folknology/IceCore/README.md

# IceCore
IceCore Ice40 HX based modular developement core 

**Top View**
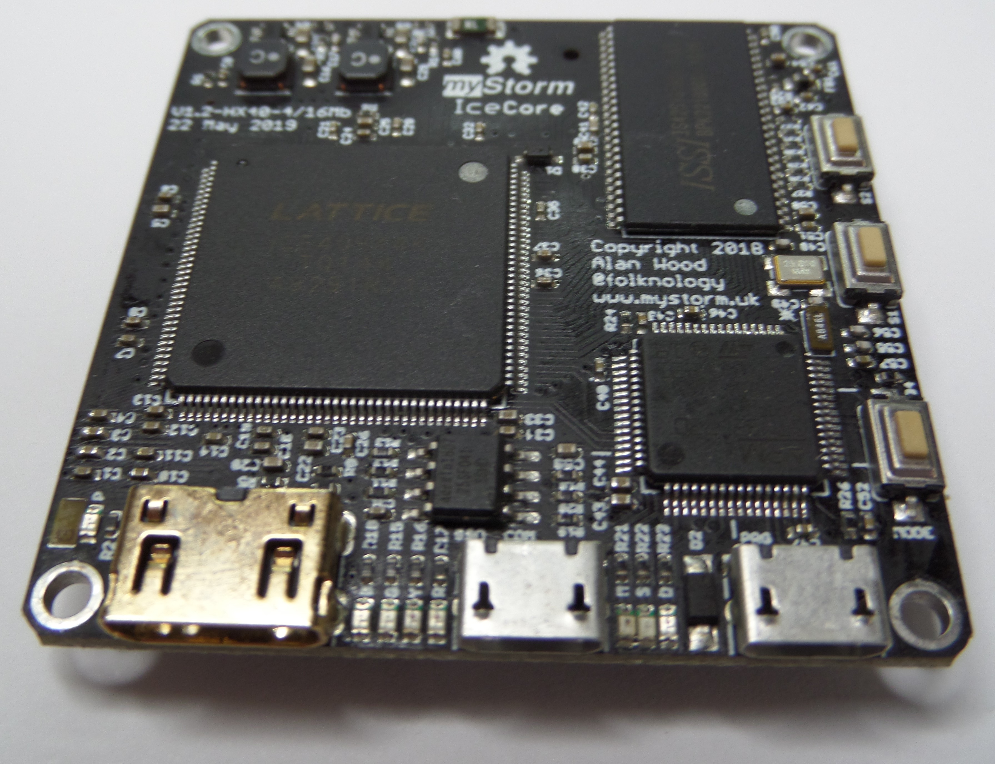
[picture p1: cad/IceCore.jpg]
IceCore Module

**Bottom View**
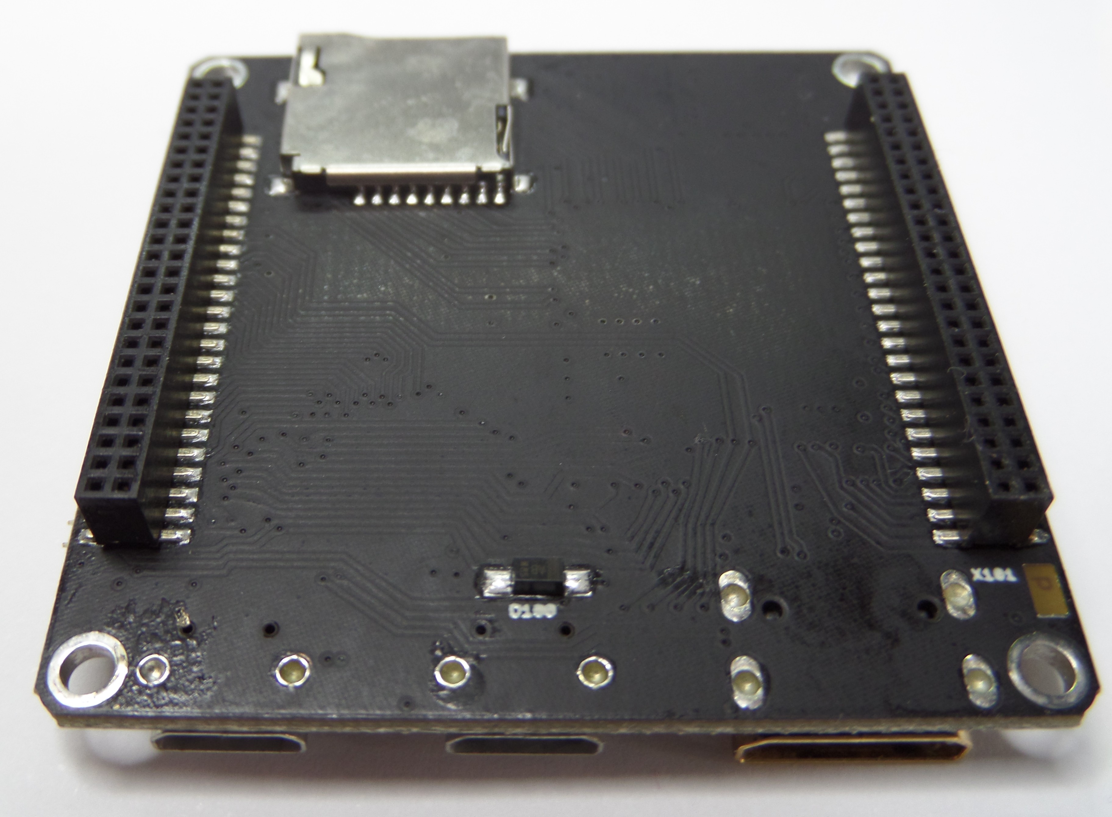
[picture p2: cad/IceCore-Bottom.jpg]
IceCore Module


**Features**
* Ice40 HX4K - 4K Luts (8K for Yosys), 80/(128)Kbits BRAM, 2 PLLs, NVCM
* 16Mbit SDRAM 16 bits wide (143Mhz)
* 16Mbit Flash QSPI/SPI (100Mhz)
* 56 General purpose IOs, SPI, Uart, I2C/Can
* Stm32F730 200Mhz, 256KB Ram, 64KB Flash
* Triple 2.5MSPS ADCs (interleaved to 7.2MSPS)
* Dedicated Programming and debug USB 2.0FS
* Uart/Application specific USB2.0FS
* Digital video connector
* SDCard connector
* 4 Coloured Status LEDs
* 4 Coloured User LEDs
* 2 User buttons, 1 Mode/Boot buttoni

[Get it from Tindie as part of BlackIce Mx](https://www.tindie.com/products/Folknology/blackice-mx/)

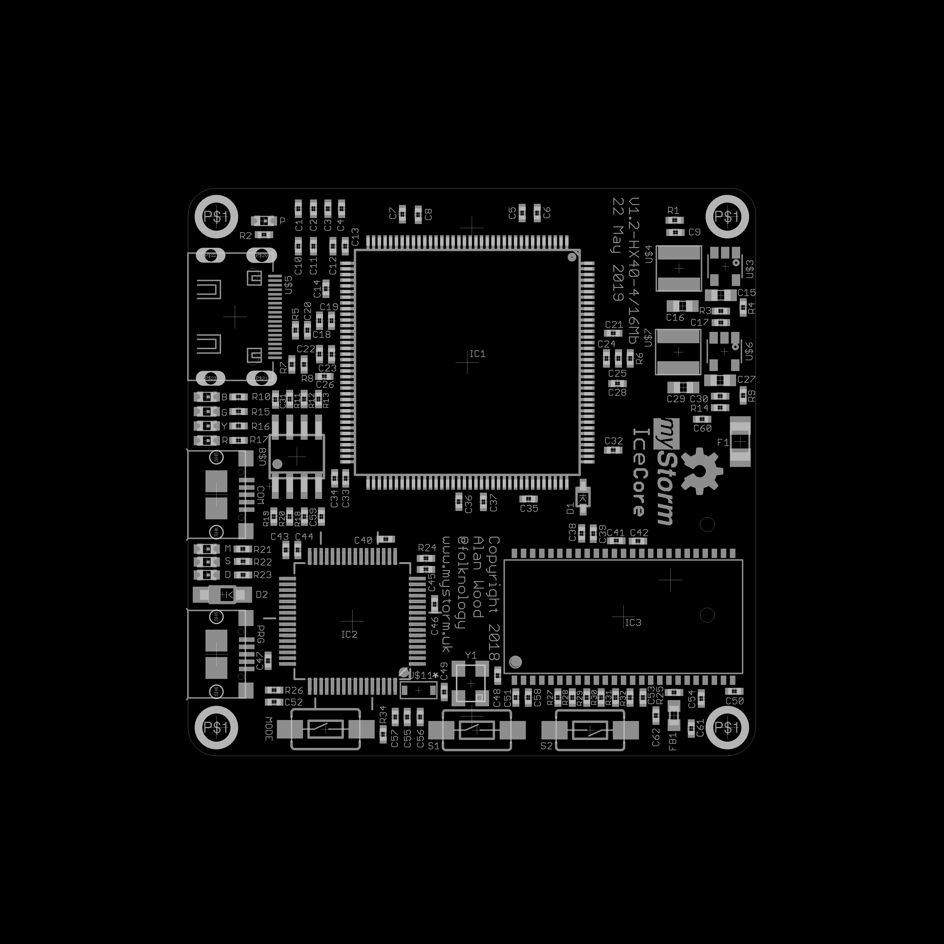
[picture p3: cad/IceCore.png]
IceCore Module


Schematic

Core modules can be combined with different carrier boards for example [BlackIce Mx](https://github.com/folknology/BlackIceMx)

Supports the [BlackEdge connectivity](https://github.com/folknology/BlackEdge) carriers

Some further [background information](https://forum.mystorm.uk/t/new-product-blackice-mx/551/10) can be found on the [myStorm forum](https://forum.mystorm.uk)
