folknology/IceCore/(threads)

Thread 4 (2019-07-11):

Add 2nd USB support

folknology, 2019-07-11:
Add support for 2nd USB CDC class in firmware based around USB HS and Uart1

folknology, 2019-07-29:
A preview of the new firmware including this functionality along with refactored Ice40 programming code in C++ https://github.com/folknology/IceCore/tree/USB-CDC-issue-3

rvalles, 2020-11-03:
@folknology
I'm trying to support blackice mx on [some project](https://github.com/rvalles/dbus_ti_link_uart_verilog/).
stm32 uart baud rate facing the FPGA is hardcoded to 115200. Combined with the lack of hardware flow control, my design's FIFO does overrun, thus I have to depend on an external usb-serial converter, as the alternative would be too much work for one board's special case.
It would be best if uart speed was set to computer's requested speed.
