folknology/IceCore/cad/IceCore-Schematic.pdf

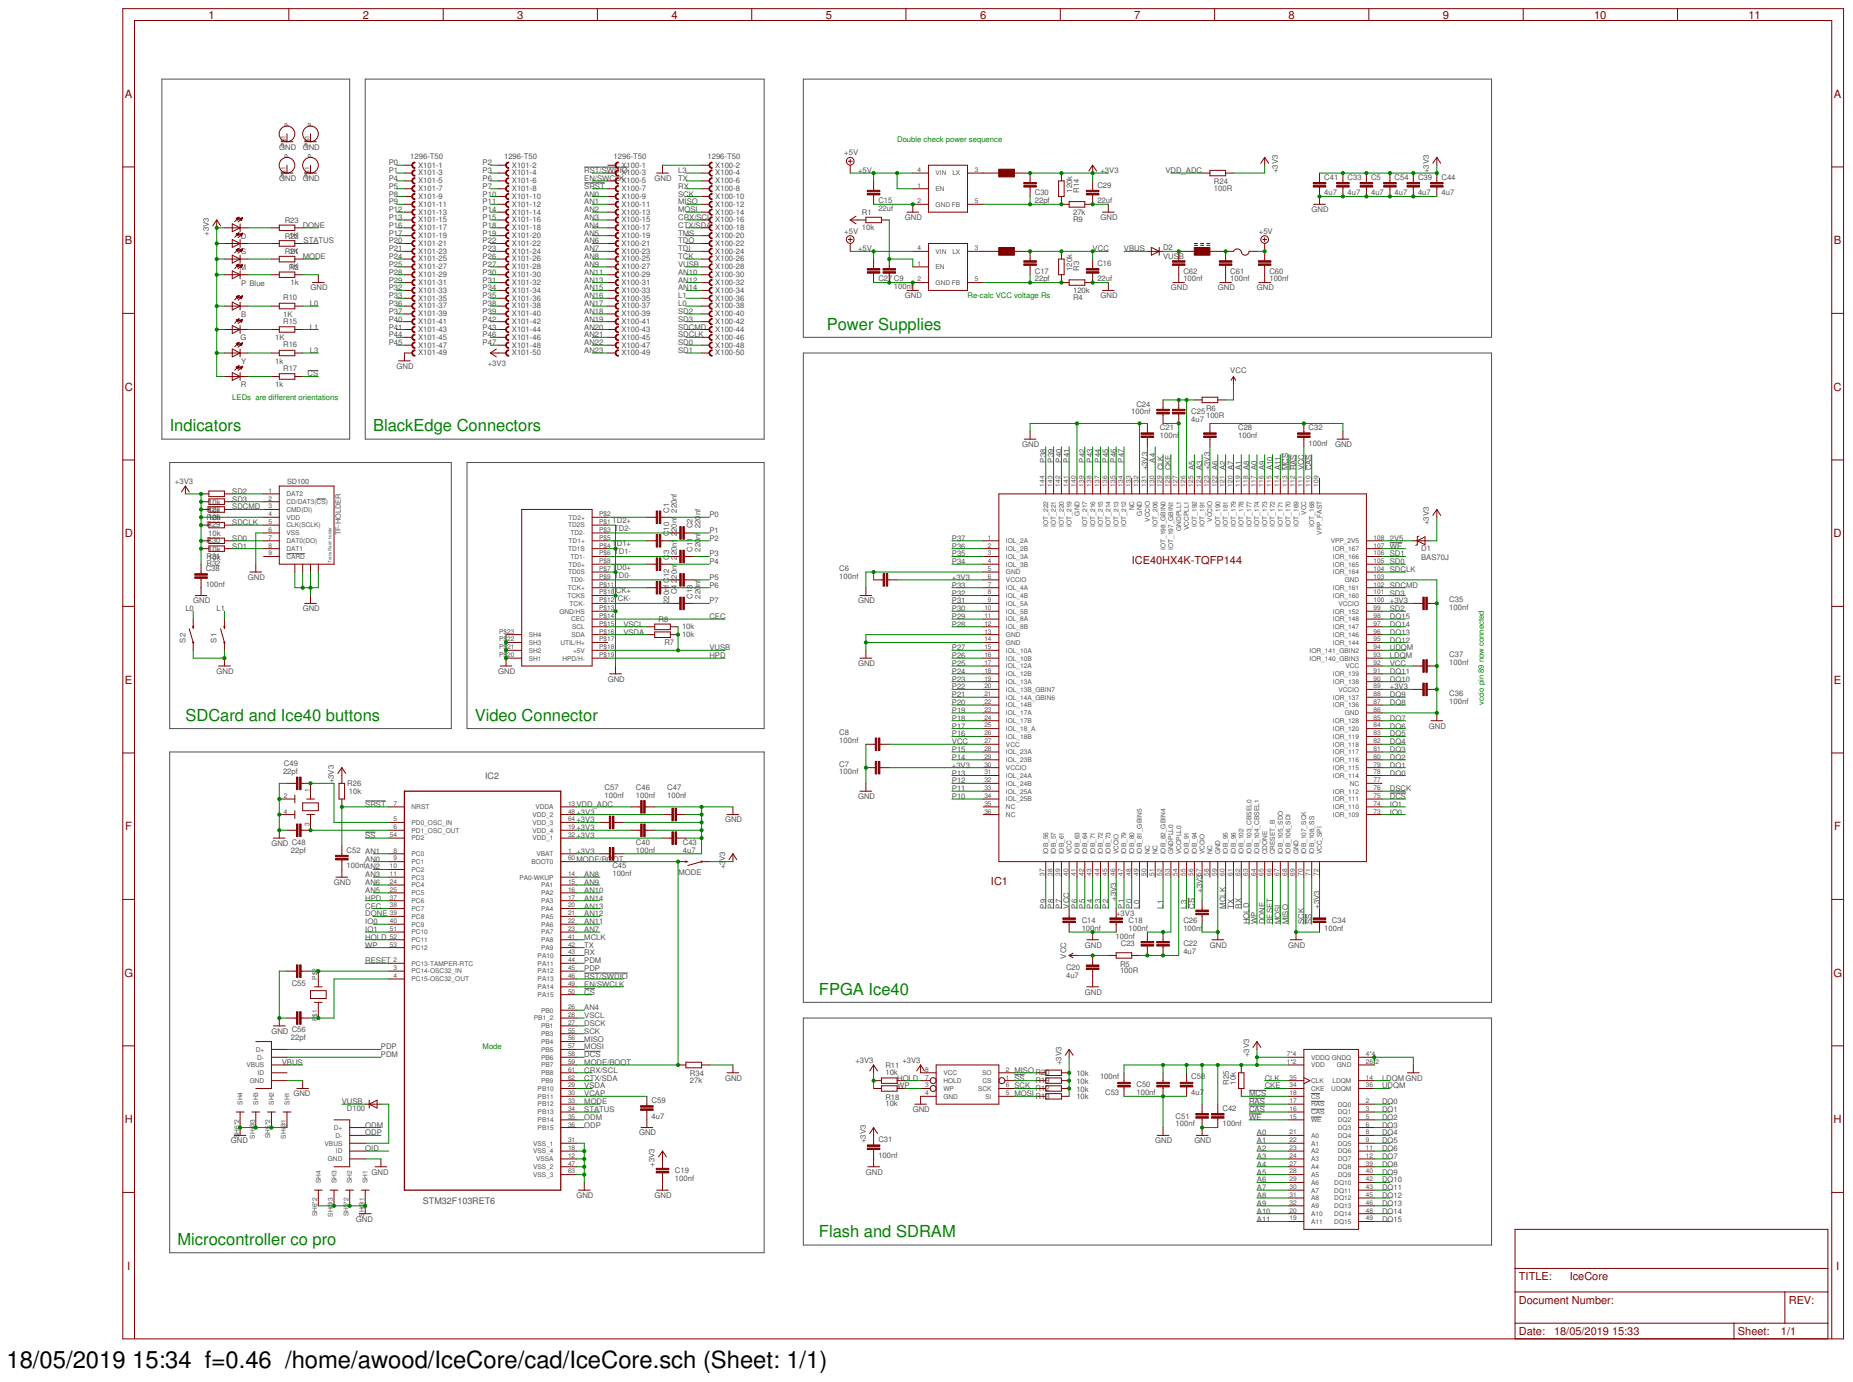
[picture p4: page 1]

GND GND

Double check power sequence

Re-calc VCC voltage Rs

LEDs are different orientations

vccio pin 89 now connected

Flash and SDRAM Microcontroller co pro

18/05/2019 15:34 f=0.46 /home/awood/IceCore/cad/IceCore.sch (Sheet: 1/1)
