folknology/IceCore/firmware/IceCore.ioc

Mcu.UserName=STM32F730R8Tx
PA0-WKUP.Signal=ADCx_IN0
PA1.Signal=ADCx_IN1
PA10.Signal=USART1_RX
PA11.Signal=USB_OTG_FS_DM
PA12.Signal=USB_OTG_FS_DP
PA13.Signal=SYS_JTMS-SWDIO
PA14.Signal=SYS_JTCK-SWCLK
PA15.Signal=SPI3_NSS
PA2.Signal=ADCx_IN2
PA3.Signal=ADCx_IN3
PA4.Signal=ADCx_IN4
PA5.Signal=ADCx_IN5
PA6.Signal=ADCx_IN6
PA7.Signal=ADCx_IN7
PA8.Signal=RCC_MCO_1
PA9.Signal=USART1_TX
PB0.Signal=ADCx_IN8
PB1.Signal=ADCx_IN9
PB10.Signal=I2C2_SCL
PB11.Signal=I2C2_SDA
PB12.GPIO_Label=MODE_LED
PB12.Signal=GPIO_Output
PB13.GPIO_Label=STATUS_LED
PB13.Signal=GPIO_Output
PB14.Signal=USB_OTG_HS_DM
PB15.Signal=USB_OTG_HS_DP
PB2.Signal=QUADSPI_CLK
PB3.Signal=SPI3_SCK
PB4.Signal=SPI3_MISO
PB5.Signal=SPI3_MOSI
PB6.Signal=QUADSPI_BK1_NCS
PB7.GPIO_Label=MODE_BOOT
PB7.Signal=GPIO_Input
PB8.Signal=I2C1_SCL
PB9.Signal=I2C1_SDA
PC0.Signal=ADCx_IN10
PC1.Signal=ADCx_IN11
PC10.Signal=QUADSPI_BK1_IO1
PC11.GPIO_Label=ICE40_HOLD
PC11.Signal=GPIO_Output
PC12.GPIO_Label=ICE40_WP
PC12.Signal=GPIO_Output
PC13.GPIO_Label=ICE40_CRST
PC13.Signal=GPIO_Output
PC14-OSC32_IN.Signal=RCC_OSC32_IN
PC15-OSC32_OUT.Signal=RCC_OSC32_OUT
PC2.Signal=ADCx_IN12
PC3.Signal=ADCx_IN13
PC4.Signal=ADCx_IN14
PC6.GPIO_Label=HDMI_HPD
PC6.Signal=GPIO_Input
PC7.GPIO_Label=HDMI_CEC
PC7.Signal=GPIO_Output
PC8.GPIO_Label=ICE40_CDONE
PC8.Signal=GPIO_Input
PC9.Signal=QUADSPI_BK1_IO0
PD2.GPIO_Label=ICE40_SPI_CS
PD2.Signal=GPIO_Input
PH0-OSC_IN.Signal=RCC_OSC_IN
PH1-OSC_OUT.Signal=RCC_OSC_OUT
