folknology/IceCore/(commit log)

2019-05-18 Initial commit of IceCore cad
    [IceCore.brd, IceCore.sch]
2019-05-18 Added solderpad hardware license
2019-05-18 Added Schematic preview image
2019-05-18 Added Schematic preview image to readme
2019-05-18 Added IceCore Bottom of board shot
2019-05-18 Updated IceCore date information in CAD
    [IceCore.brd]
2019-07-02 Changed blink to red led rather than blue (also button!)
2019-07-03 Fixed led index, doh!
    [chip.v]
2019-07-03 Updated IceCore JPEG to manufactured board
2019-07-03 Updated IceCore bottom JPEG to manufactured board
2019-07-03 Updated IceCore board
2019-07-04 Added missing Drivers for the firmware
2019-07-06 Corrected SRAM clock name to rclk in pcf file
    [blackice-mx.pcf]
