folknology/IceCore/(notices)

Notices in the files:
cad/IceCore.brd:
Copyright 2018
parts and their libraries:
SparkFun-Electromechanical: Licensing: Creative Commons ShareAlike 4.0 International - https://creativecommons.org/licenses/by-sa/4.0
